blongworth/pico-co2/REV_X/hardware/picoco2.kicad_pcb

## KiCad design REV_X/hardware/picoco2.kicad_pcb (2023-03-04)

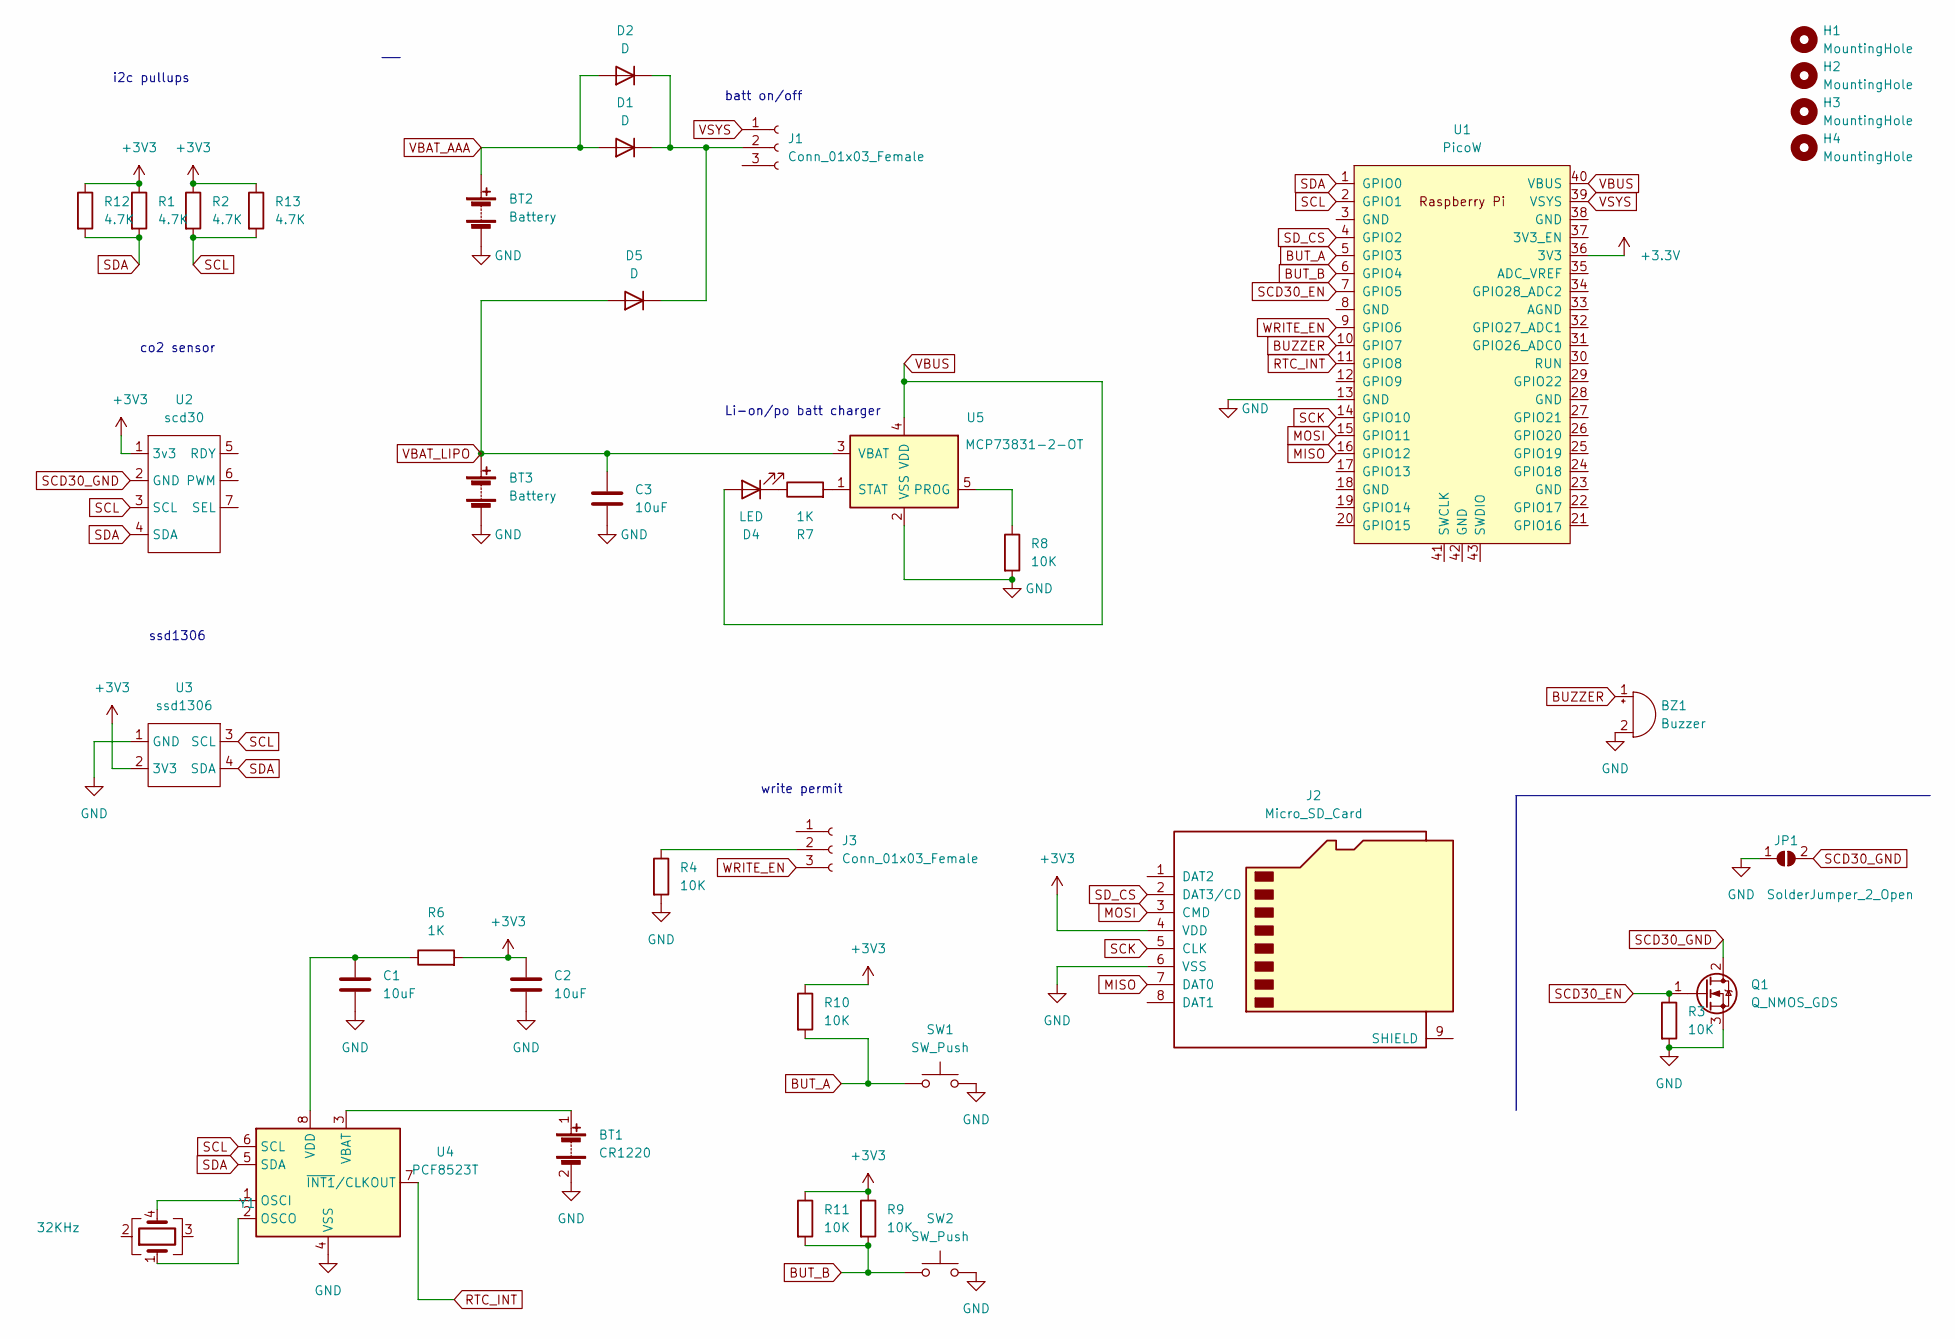
[picture p1: schematic picoco2.kicad_sch]

Parts:
BT1: CR1220; CR1220-2
BT2: Battery; BatteryHolder_Keystone_2468_2xAAA
BT3: Battery; JST_PH_S2B-PH-SM4-TB_1x02-1MP_P2.00mm_Horizontal
BZ1: Buzzer; MagneticBuzzer_Kobitone_254-EMB84Q-RO
C1, C2, C3: 10uF; C_0603_1608Metric_Pad1.08x0.95mm_HandSolder
D1, D5: D; D_SOD-123F
D2: D; D_5W_P10.16mm_Horizontal
D4: LED; LED_0603_1608Metric_Pad1.05x0.95mm_HandSolder
H1, H2, H3, H4: MountingHole; MountingHole_3.2mm_M3
J1, J3: Conn_01x03_Female; PinSocket_1x03_P2.54mm_Vertical
J2: Micro_SD_Card; DM3D-SF_outline
JP1: SolderJumper_2_Open; SolderJumper-2_P1.3mm_Open_Pad1.0x1.5mm
Q1: Q_NMOS_GDS; SOT-23
R1, R2: 4.7K; R_0603_1608Metric_Pad0.98x0.95mm_HandSolder
R3, R4, R8, R9: 10K; R_0603_1608Metric_Pad0.98x0.95mm_HandSolder
R6, R7: 1K; R_0603_1608Metric_Pad0.98x0.95mm_HandSolder
R10, R11: 10K; R_Axial_DIN0204_L3.6mm_D1.6mm_P7.62mm_Horizontal
R12, R13: 4.7K; R_Axial_DIN0204_L3.6mm_D1.6mm_P7.62mm_Horizontal
SW1, SW2: SW_Push; SW_Tactile_SPST_Angled_PTS645Vx31-2LFS
U1: PicoW; RPi_PicoW_SMD
U2: scd30; scd30_a
U3: ssd1306; ssd1306_a
U4: PCF8523T; SOIC-8_3.9x4.9mm_P1.27mm
U5: MCP73831-2-OT; SOT-23-5
Y1: 32KHz; Crystal_SMD_Abracon_ABS25-4Pin_8.0x3.8mm

Connections:
BUT_A: R10.2, SW1.1, U1.5 (GPIO3)
BUT_B: R9.2, R11.2, SW2.1, U1.6 (GPIO4)
BUZZER: BZ1.1 (-), U1.10 (GPIO7)
GND: BT1.2 (-), BT2.2 (-), BT3.2 (-), BZ1.2 (+), C1.2, C2.2, C3.2, J2.6 (VSS), JP1.1 (A), Q1.3 (S), R3.2, R4.2, R8.2, SW1.2, SW2.2, U1.13 (GND), U3.1 (GND), U4.4 (VSS), U5.2 (VSS)
MISO: J2.7 (DAT0), U1.16 (GPIO12)
MOSI: J2.3 (CMD), U1.15 (GPIO11)
unnamed: BT1.1 (+), U4.3 (VBAT)
unnamed: C1.1, R6.1, U4.8 (VDD)
unnamed: D1.1 (K), D2.1 (K), D5.1 (K), J1.2
unnamed: D4.1 (K), R7.1
unnamed: J3.2, R4.1
unnamed: R7.2, U5.1 (STAT)
unnamed: R8.1, U5.5 (PROG)
unnamed: U4.1 (OSCI), Y1.4
unnamed: U4.2 (OSCO), Y1.1
RTC_INT: U1.11 (GPIO8), U4.7 (~INT1/CLKOUT)
SCD30_EN: Q1.1 (G), R3.1, U1.7 (GPIO5)
SCD30_GND: JP1.2 (B), Q1.2 (D), U2.2 (GND)
SCK: J2.5 (CLK), U1.14 (GPIO10)
SCL: R2.2, R13.2, U1.2 (GPIO1), U2.3 (SCL), U3.3 (SCL), U4.6 (SCL)
SDA: R1.2, R12.2, U1.1 (GPIO0), U2.4 (SDA), U3.4 (SDA), U4.5 (SDA)
SD_CS: J2.2 (DAT3/CD), U1.4 (GPIO2)
VBAT_AAA: BT2.1 (+), D1.2 (A), D2.2 (A)
VBAT_LIPO: BT3.1 (+), C3.1, D5.2 (A), U5.3 (VBAT)
VBUS: D4.2 (A), U1.40 (VBUS), U5.4 (VDD)
VSYS: J1.1, U1.39 (VSYS)
WRITE_EN: J3.3, U1.9 (GPIO6)

Notes on the sheet:
i2c pullups
write permit
batt on/off
Li-on/po batt charger
co2 sensor
ssd1306

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
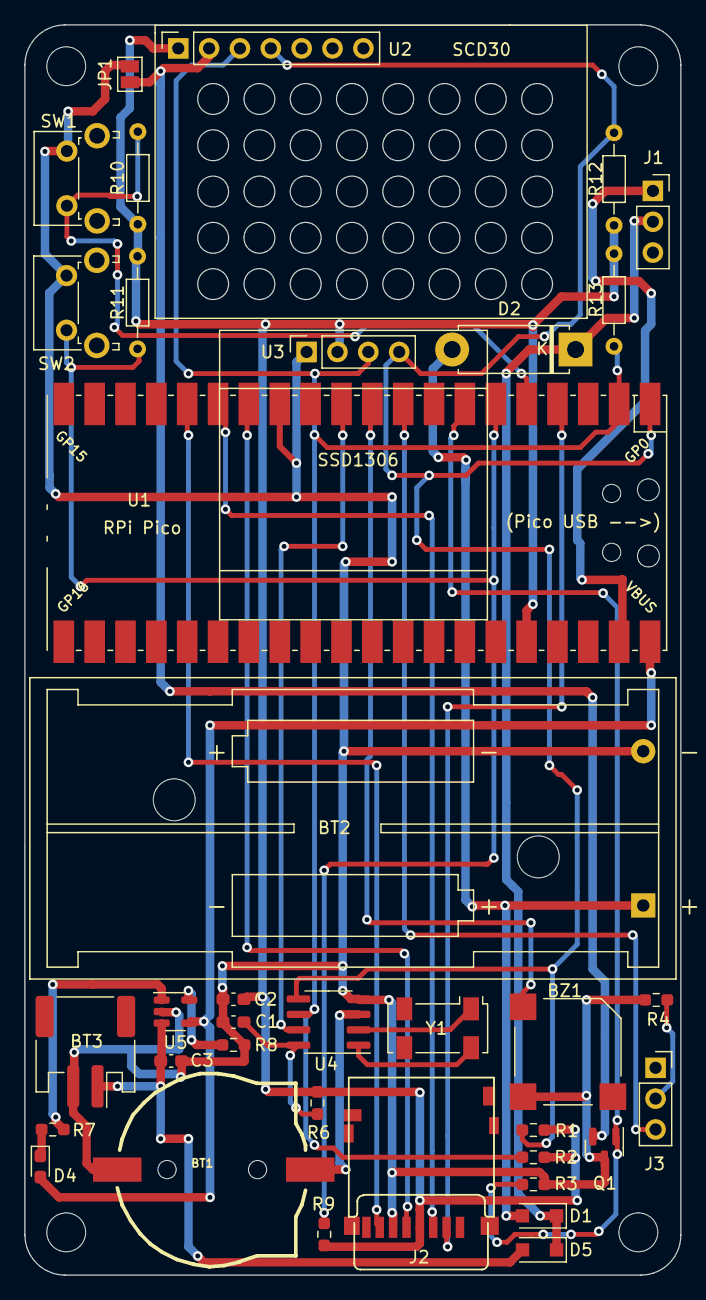
[picture p2: board picoco2.kicad_pcb from above]

Board: 2 copper layers, 54.0 x 102.9 mm, 40 parts (0 on the bottom side), 28 nets.
